laoeked1111/stepper-motor-driver/README.md

# stepper-motor-driver
Power electronics final project
