laoeked1111/stepper-motor-driver/(commit log)

2025-11-24 created schematic
    [full-step.kicad_sch, stepper-motor-driver.kicad_pcb, stepper-motor-driver.kicad_sch]
2025-12-09 schematic mostly done except gate drivers
    [boost-converter.kicad_sch, boost-gate-driver.kicad_sch, full-step.kicad_sch, gate-drivers.kicad_sch, h-bridge.kicad_sch, stepper-motor-driver.kicad_sch]
2025-12-11 finished schematic
2025-12-11 gate drivers
    [boost-converter.kicad_sch, boost-gate-driver.kicad_sch, gate-drivers.kicad_sch]
2025-12-11 schematic for motor driver by itself
    [control.kicad_sch, gate-drivers.kicad_sch, h-bridge.kicad_sch, motor-driver.kicad_pcb, motor-driver.kicad_sch]
2025-12-13 power final project write up
    [boost-converter.kicad_sch, boost-gate-driver.kicad_sch, full-step.kicad_sch, gate-drivers.kicad_sch, h-bridge.kicad_sch, stepper-motor-driver.kicad_pcb, stepper-motor-driver.kicad_sch]
2025-12-14 pcb layout
    [control.kicad_sch, gate-drivers.kicad_sch, h-bridge.kicad_sch, motor-driver.kicad_pcb, motor-driver.kicad_sch]
2025-12-18 fab files
    [bom.csv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]
2026-01-14 fixed missing connections on gate drivers
    [bom.csv, control.kicad_sch, gate-drivers.kicad_sch, h-bridge.kicad_sch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]
2026-01-18 fixed schematic
    [bom.csv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]
2026-01-22 code for stepper motor music
